woshinamoda/AD7768-/README.md

# AD7768
STM32H750采集ADI驱动数据
***

## 前言
有些朋友在github上看到了我AD7768的工程，从B站找到我咨询代码问题。由于确实有些学生毕设或者导师要求用到这个片子，我这边为了方便大家快速上手，重新整理更新一下内容。<br>

1. 我重新更新了代码，原先上传的原理图里直接用STM32主控读取有问题，需要修改飞线，在后面《程序说明文档注释》我有内部详细解释
2. 添加两个说明文档，方便大家快速上手这个片子电路设计思路和对应程序内寄存器配置思路

***
>* 更新2024-08-28 下
1. 添加程序说明文档注释
2. 添加serial plot上位机软件

***
>* 更新2024-08-28

1.添加原理图文档注释
*   1->详细解释了AD7768开发板设计原理图思路
*   2->讲述原理图电源和配置AD7768的方式
*   3->解释一些预留焊盘和设置阻容的功能

2.修改firmware<br>
修改内容：新增自己按照寄存器配置的函数和功能<br>
大体思路：通过STM32的spi1来配置AD7768的寄存器<br>
通过STM32的spi4从机模式，由AD7768的DCLK提供时钟，由AD7768的DRDY来模拟spi的cs引脚，读取AD7768的DOUT0输入<br>

>* 更新2023-08-10

1.更新AD7768新版程序
2.新增嘉立创原理图
3.更新picture设计图
