woshinamoda/AD7768-/picture/AD7768.png

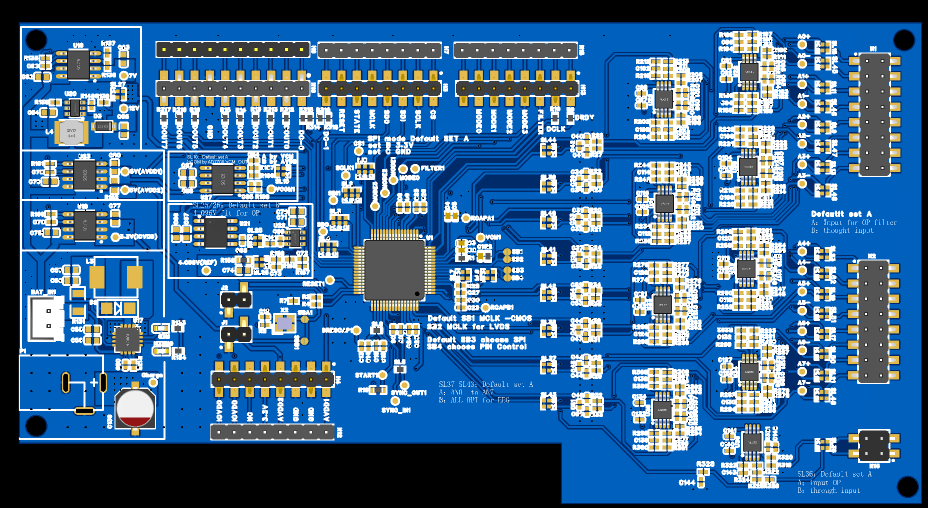
picture/AD7768.png
