woshinamoda/AD7768-/picture/STM32H750.png

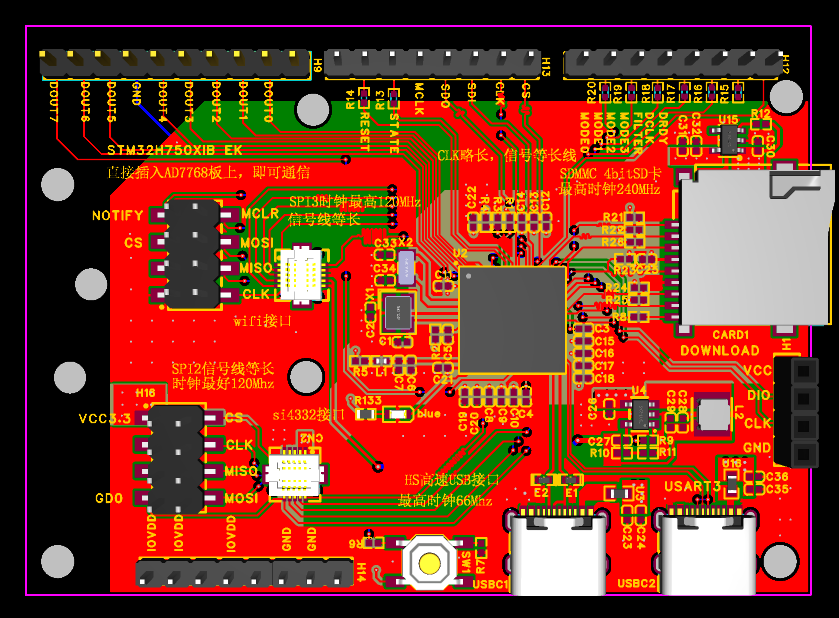
picture/STM32H750.png
