woshinamoda/AD7768-/(threads)

Thread 2 (2024-05-18):

mlck的分频系数是不是缺少16分频

yangkkokk, 2024-05-18:
typedef enum {
	AD7768_MCLK_DIV_32 = 0,
	AD7768_MCLK_DIV_8 = 2,
	AD7768_MCLK_DIV_4 = 3,
} ad7768_mclk_div;
这里是否缺少16分频，为何不用低功耗模式16分频，官方推荐的

woshinamoda, 2024-05-19:
这个只是我测试随便写的。因为我是用STM32的SPI从机读取数据，并不是并口的FPGA。采样率高对spi的时钟也就是DCLK有要求，DCLK是由MCLK分频的，我就默认都用最高速率
