woshinamoda/AD7768-/嘉立创原理图/STM32H750开发板.pdf

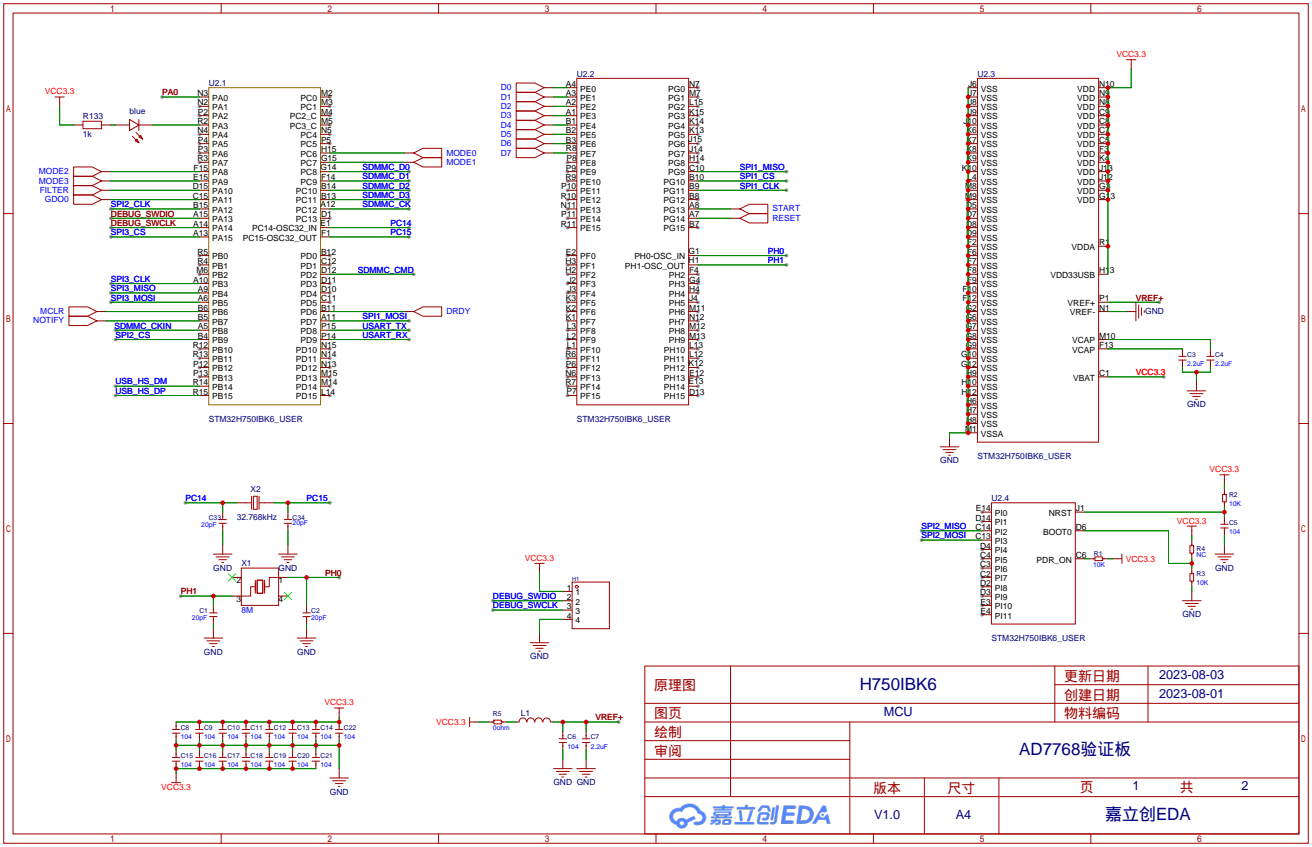
[picture p8: page 1]

VDD C5 VDD C7 VDD C8 VDD C9

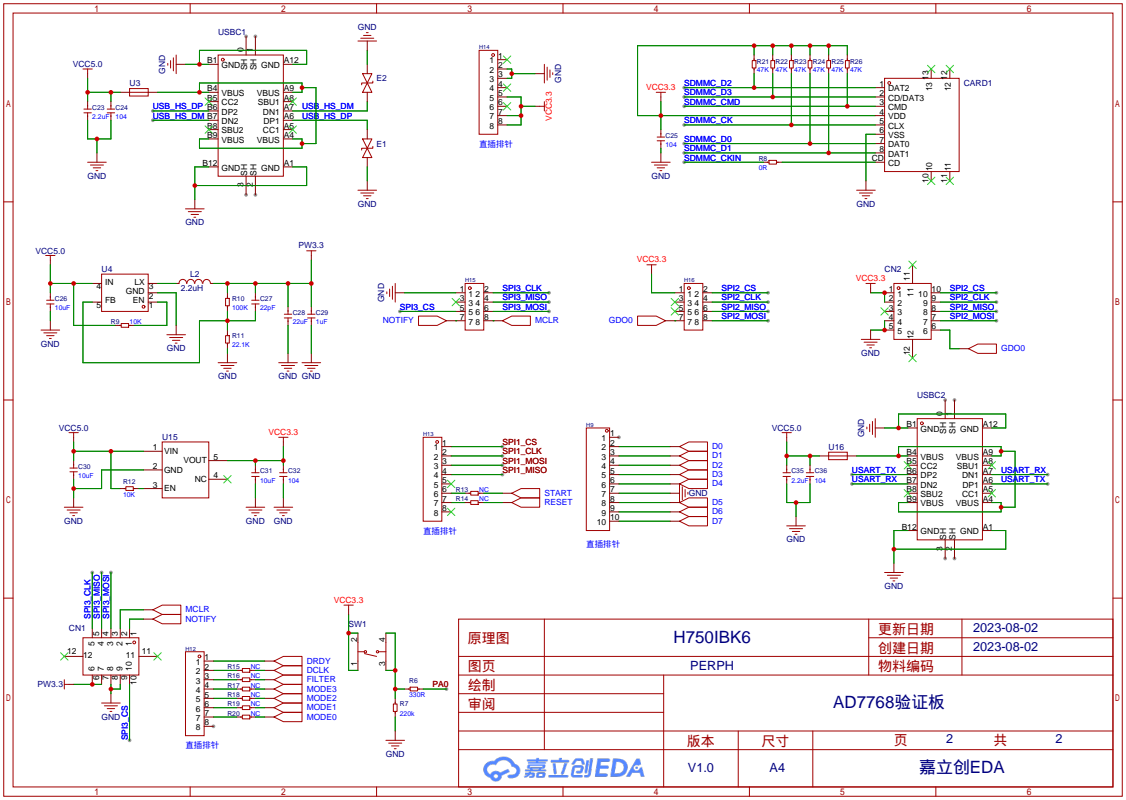
[picture p9: page 2]
