woshinamoda/AD7768-/firmware/Core/Src/main.c

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
/* Includes ------------------------------------------------------------------*/
#include "main.h"
#include "spi.h"
#include "tim.h"
#include "usart.h"
#include "usb_device.h"
#include "usb_otg_hs.h"
#include "gpio.h"

/* USER CODE BEGIN Includes */
#include "uApp_other.h"
#include "uApp_AD7768.h"
#include "uspi.h"
#include "ugpio.h"
/* USER CODE END Includes */


void SystemClock_Config(void);
void PeriphCommonClock_Config(void);
/**
  * @brief  The application entry point.
  * @retval int
  */
int main(void)
{
  /* MCU Configuration--------------------------------------------------------*/

  /* Reset of all peripherals, Initializes the Flash interface and the Systick. */
  HAL_Init();

  /* Configure the system clock */
  SystemClock_Config();

/* Configure the peripherals common clocks */
  PeriphCommonClock_Config();

  /* Initialize all configured peripherals */
  MX_GPIO_Init();
  MX_SPI1_Init();
  MX_USART3_UART_Init();
  MX_USB_DEVICE_Init();
  MX_TIM15_Init();
  MX_SPI4_Init();
  MX_USB_OTG_HS_PCD_Init();
  /* USER CODE BEGIN 2 */
	HAL_TIM_Base_Start_IT(&htim15);		//开启系统tick 

  /* USER CODE END 2 */

  /* Infinite loop */
  /* USER CODE BEGIN WHILE */
	my_ad7768_init();
  while (1)
  {

    /* USER CODE END WHILE */

    /* USER CODE BEGIN 3 */
  }
  /* USER CODE END 3 */
}

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
/* USER CODE BEGIN 4 */
void HAL_TIM_PeriodElapsedCallback(TIM_HandleTypeDef *htim)
{
  if (htim->Instance == TIM15) 
	{ //周期定时tick = 1ms
   	LED_Blinky();					//系统指示灯
  }

}
/* USER CODE END 4 */
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
