woshinamoda/AD7768-/firmware/Core/Inc/main.h

#define RESET_Pin GPIO_PIN_14
#define RESET_GPIO_Port GPIOG
#define START_Pin GPIO_PIN_13
#define START_GPIO_Port GPIOG
#define NOTIFY_Pin GPIO_PIN_7
#define NOTIFY_GPIO_Port GPIOB
#define MCLR_Pin GPIO_PIN_6
#define MCLR_GPIO_Port GPIOB
#define SPI1_CS_Pin GPIO_PIN_10
#define SPI1_CS_GPIO_Port GPIOG
#define DRDY_Pin GPIO_PIN_6
#define DRDY_GPIO_Port GPIOD
#define DRDY_EXTI_IRQn EXTI9_5_IRQn
#define FILTER_Pin GPIO_PIN_10
#define FILTER_GPIO_Port GPIOA
#define MODE3_Pin GPIO_PIN_9
#define MODE3_GPIO_Port GPIOA
#define MODE2_Pin GPIO_PIN_8
#define MODE2_GPIO_Port GPIOA
#define MODE1_Pin GPIO_PIN_7
#define MODE1_GPIO_Port GPIOC
#define MODE0_Pin GPIO_PIN_6
#define MODE0_GPIO_Port GPIOC
#define KEY_PA0_Pin GPIO_PIN_0
#define KEY_PA0_GPIO_Port GPIOA
#define LED_Pin GPIO_PIN_3
#define LED_GPIO_Port GPIOA
#define D7_Pin GPIO_PIN_7
#define D7_GPIO_Port GPIOE
#define CS_L 	HAL_GPIO_WritePin(GPIOG, GPIO_PIN_10, (GPIO_PinState)0)
#define CS_H	HAL_GPIO_WritePin(GPIOG, GPIO_PIN_10, (GPIO_PinState)1)
