woshinamoda/AD7768-/firmware/APPlication/uApp_AD7768.h

/***************************************************************************//**
 *   @file   ad7768.h
 *   @brief  Header file of AD7768 Driver.
 *   @author DBogdan (dragos.bogdan@analog.com)
********************************************************************************
 * Copyright 2016(c) Analog Devices, Inc.
 *
 * All rights reserved.
 *
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
 * THIS SOFTWARE IS PROVIDED BY ANALOG DEVICES "AS IS" AND ANY EXPRESS OR
 * IMPLIED WARRANTIES, INCLUDING, BUT NOT LIMITED TO, NON-INFRINGEMENT,
 * MERCHANTABILITY AND FITNESS FOR A PARTICULAR PURPOSE ARE DISCLAIMED.
 * IN NO EVENT SHALL ANALOG DEVICES BE LIABLE FOR ANY DIRECT, INDIRECT,
 * INCIDENTAL, SPECIAL, EXEMPLARY, OR CONSEQUENTIAL DAMAGES (INCLUDING, BUT NOT
 * LIMITED TO, INTELLECTUAL PROPERTY RIGHTS, PROCUREMENT OF SUBSTITUTE GOODS OR
 * SERVICES; LOSS OF USE, DATA, OR PROFITS; OR BUSINESS INTERRUPTION) HOWEVER
 * CAUSED AND ON ANY THEORY OF LIABILITY, WHETHER IN CONTRACT, STRICT LIABILITY,
 * OR TORT (INCLUDING NEGLIGENCE OR OTHERWISE) ARISING IN ANY WAY OUT OF THE USE
 * OF THIS SOFTWARE, EVEN IF ADVISED OF THE POSSIBILITY OF SUCH DAMAGE.
*******************************************************************************/
#ifndef UAPP_AD7768_H_
#define UAPP_AD7768_H_

/***********************SPI 4 interface **********************************
 SPI4 从机模式，请看手册P65详情描述
 硬件接口D2 接到 CLK		D2引脚为PE2，sck接到dclk上，用于接收数字时钟
 硬件接口D5 接到 D0			D5引脚为PE4，miso接到D0上，用于接收数据
 原先D0对应PA4引脚不要初始化，置为高阻态，否则影响输出
 
 = = = 接收包数据格式P62
 = = = SL6 SL7都接A，8个通道数据通过D0 1线传输，figure 99 // SPI速率60Mhz

SPI1 全双工主机模式
spi1数据格式，详细配置P50
= = = SB3接通，取消PIN Control

*************************************************************************/

#include "main.h"
#include "uspi.h"
#include "ugpio.h"
#include "sai.h"

/******************************************************************************/
/********************** Macros and Constants Definitions **********************/
/******************************************************************************/
#define AD7768_8_CH  											4
#define AD7768_REG_CH_STANDBY							0x00
#define AD7768_REG_CH_MODE_A							0x01
#define AD7768_REG_CH_MODE_B							0x02
#define AD7768_REG_CH_MODE_SEL						0x03
#define AD7768_REG_PWR_MODE								0x04
#define AD7768_REG_GENERAL_CFG						0x05
#define AD7768_REG_DATA_CTRL							0x06
#define AD7768_REG_INTERFACE_CFG					0x07
#define AD7768_REG_BIST_CTRL							0x08
#define AD7768_REG_DEV_STATUS							0x09
#define AD7768_REG_REV_ID									0x0A
#define AD7768_REG_DEV_ID_MSB							0x0B
#define AD7768_REG_DEV_ID_LSB							0x0C
#define AD7768_REG_SW_REV_ID							0x0D
#define AD7768_REG_GPIO_CTRL							0x0E
#define AD7768_REG_GPIO_WR_DATA						0x0F
#define AD7768_REG_GPIO_RD_DATA						0x10
#define AD7768_REG_PRECHARGE_BUF_1				0x11
#define AD7768_REG_PRECHARGE_BUF_2				0x12
#define AD7768_REG_POS_REF_BUF						0x13
#define AD7768_REG_NEG_REF_BUF						0x14
#define AD7768_REG_CH_OFFSET_1(ch)				(0x1E + (ch) * 3)
#define AD7768_REG_CH_OFFSET_2(ch)				(0x1F + (ch) * 3)
#define AD7768_REG_CH_OFFSET_3(ch)				(0x20 + (ch) * 3)
#define AD7768_REG_CH_GAIN_1(ch)					(0x36 + (ch) * 3)
#define AD7768_REG_CH_GAIN_2(ch)					(0x37 + (ch) * 3)
#define AD7768_REG_CH_GAIN_3(ch)					(0x38 + (ch) * 3)
#define AD7768_REG_CH_SYNC_OFFSET(ch)			(0x4E + (ch) * 3)
#define AD7768_REG_DIAG_METER_RX					0x56
#define AD7768_REG_DIAG_CTRL							0x57
#define AD7768_REG_DIAG_MOD_DELAY_CTRL		0x58
#define AD7768_REG_DIAG_CHOP_CTRL					0x59

/* AD7768_REG_CH_STANDBY */
#define AD7768_CH_STANDBY(x)							(1 << (x))

/* AD7768_REG_CH_MODE_x */
#define AD7768_CH_MODE_FILTER_TYPE				(1 << 3)
#define AD7768_CH_MODE_DEC_RATE(x)				(((x) & 0x7) << 0)

/* AD7768_REG_CH_MODE_SEL */
#define AD7768_CH_MODE(x)									(1 << (x))

/* AD7768_REG_PWR_MODE */
#define AD7768_PWR_MODE_SLEEP_MODE				(1 << 7)
#define AD7768_PWR_MODE_POWER_MODE(x)			(((x) & 0x3) << 4)
#define AD7768_PWR_MODE_LVDS_ENABLE				(1 << 3)
#define AD7768_PWR_MODE_MCLK_DIV(x)				(((x) & 0x3) << 0)

/* AD7768_REG_DATA_CTRL */
#define AD7768_DATA_CTRL_SPI_SYNC					(1 << 7)
#define AD7768_DATA_CTRL_SINGLE_SHOT_EN		(1 << 4)
#define AD7768_DATA_CTRL_SPI_RESET(x)			(((x) & 0x3) << 0)

/* AD7768_REG_INTERFACE_CFG */
#define AD7768_INTERFACE_CFG_CRC_SEL(x)		(((x) & 0x3) << 2)
#define AD7768_INTERFACE_CFG_DCLK_DIV(x)	(((x) & 0x3) << 0)

#define AD7768_RESOLUTION									24


//#define	CS_L		HAL_GPIO_WritePin(GPIOG, SPI1_CS_Pin, GPIO_PIN_RESET)
//#define	CS_H		HAL_GPIO_WritePin(GPIOG, SPI1_CS_Pin, GPIO_PIN_SET)


/******************************************************************************/
/*************************** Types Declarations *******************************/
/******************************************************************************/
typedef enum {
	AD7768_ACTIVE,
	AD7768_SLEEP,
} ad7768_sleep_mode;				//睡眠模式选择

typedef enum {
	AD7768_ECO = 0,
	AD7768_MEDIAN = 2,
	AD7768_FAST = 3,
} ad7768_power_mode;				//功率模式选择

typedef enum {
	AD7768_MCLK_DIV_32 = 0,
	AD7768_MCLK_DIV_8 = 2,
	AD7768_MCLK_DIV_4 = 3,
} ad7768_mclk_div;					//MCLK分频选择

typedef enum {
	AD7768_DCLK_DIV_8,
	AD7768_DCLK_DIV_4,
	AD7768_DCLK_DIV_2,
	AD7768_DCLK_DIV_1,
} ad7768_dclk_div;					//DCLK分频选择

typedef enum {
	AD7768_PIN_CTRL,
	AD7768_SPI_CTRL,
} ad7768_pin_spi_ctrl;			//spi设置还是gpio设置

typedef enum {
	AD7768_STANDARD_CONV,
	AD7768_ONE_SHOT_CONV,
} ad7768_conv_op;						//转换方式 连续转换or一次转换

typedef enum {
	AD7768_NO_CRC,
	AD7768_CRC_4,
	AD7768_CRC_16,
	AD7768_CRC_16_2ND,
} ad7768_crc_sel;						// CRC校验选择

typedef enum {
	AD7768_CH0,
	AD7768_CH1,
	AD7768_CH2,
	AD7768_CH3,
	AD7768_CH4,
	AD7768_CH5,
	AD7768_CH6,
	AD7768_CH7,
	AD7768_CH_NO
} ad7768_ch;								//通道选择

typedef enum {
	AD7768_ENABLED,
	AD7768_STANDBY,
} ad7768_ch_state;					//设置通道状态 

typedef enum {
	AD7768_MODE_A,
	AD7768_MODE_B,
} ad7768_ch_mode;						//通道模式

typedef enum {
	AD7768_FILTER_WIDEBAND,
	AD7768_FILTER_SINC,
} ad7768_filt_type;					// 滤波器类型，少了个Digital Filter engine ？？？

typedef enum {
	AD7768_DEC_X32,
	AD7768_DEC_X64,
	AD7768_DEC_X128,
	AD7768_DEC_X256,
	AD7768_DEC_X512,
	AD7768_DEC_X1024,
	AD7768_DEC_X1024_2ND,
	AD7768_DEC_X1024_3RD,
} ad7768_dec_rate;					// 设置抽样率


typedef enum {
	dc_mode = 0,
	ac_mode = 1
}ad7768_coupling_mode;			// 耦合模式

typedef struct {
	spi_desc								*spi_desc;	
	gpio_desc								*gpio_reset;
	uint8_t									gpio_reset_value;
	gpio_desc								*gpio_mode0;
	gpio_desc								*gpio_mode1;
	gpio_desc								*gpio_mode2;
	gpio_desc								*gpio_mode3;
	uint8_t									pin_spi_input_value;
	ad7768_pin_spi_ctrl			pin_spi_ctrl;
	ad7768_sleep_mode				sleep_mode;
	ad7768_power_mode				power_mode;
	ad7768_mclk_div					mclk_div;
	ad7768_dclk_div					dclk_div;
	ad7768_conv_op					conv_op;
	ad7768_crc_sel					crc_sel;
	ad7768_ch_state					ch_state[8];
	ad7768_ch_mode					ch_mode[8];
	ad7768_filt_type				filt_type[2];
	ad7768_dec_rate					dec_rate[2];
	
	ad7768_coupling_mode coupling_mode[4];
	uint8_t IEPE[4];
	uint8_t dev_type;
	uint16_t data_block_size;
	uint32_t gain[4];
	uint8_t trig;
	uint16_t rate;
	uint16_t tail;																			//结构体尾，复位后设为0x1234
} ad7768_dev;//初始化设置

typedef struct {
	/* SPI */
	spi_init_param					spi_init;
	/* GPIO */
	int8_t									gpio_reset;
	uint8_t									gpio_reset_value;
	int8_t									gpio_mode0;
	int8_t									gpio_mode1;
	int8_t									gpio_mode2;
	int8_t									gpio_mode3;
	/* Configuration */
	uint8_t									pin_spi_input_value;
	ad7768_sleep_mode				sleep_mode;
	ad7768_power_mode				power_mode;
	ad7768_mclk_div					mclk_div;
	ad7768_dclk_div					dclk_div;
	ad7768_conv_op					conv_op;
	ad7768_crc_sel					crc_sel;
} ad7768_init_param;		//初始化参数

/******************************************************************************/
/************************ Functions Declarations ******************************/
/******************************************************************************/
/* SPI read from device. */
int32_t ad7768_spi_read(ad7768_dev *dev,
			uint8_t reg_addr,
			uint8_t *reg_data);
/* SPI write to device. */
int32_t ad7768_spi_write(ad7768_dev *dev,
			 uint8_t reg_addr,
			 uint8_t reg_data);
/* SPI read from device using a mask. */
int32_t ad7768_spi_read_mask(ad7768_dev *dev,
			     uint8_t reg_addr,
			     uint8_t mask,
			     uint8_t *data);
/* SPI write to device using a mask. */
int32_t ad7768_spi_write_mask(ad7768_dev *dev,
			      uint8_t reg_addr,
			      uint8_t mask,
			      uint8_t data);
/* Set the device sleep mode. */
int32_t ad7768_set_sleep_mode(ad7768_dev *dev,
			      ad7768_sleep_mode mode);
/* Get the device sleep mode. */
int32_t ad7768_get_sleep_mode(ad7768_dev *dev,
			      ad7768_sleep_mode *mode);
/* Set the device power mode. */
int32_t ad7768_set_power_mode(ad7768_dev *dev,
			      ad7768_power_mode mode);
/* Get the device power mode. */
int32_t ad7768_get_power_mode(ad7768_dev *dev,
			      ad7768_power_mode *mode);
/* Set the MCLK divider. */
int32_t ad7768_set_mclk_div(ad7768_dev *dev,
			    ad7768_mclk_div clk_div);
/* Get the MCLK divider. */
int32_t ad7768_get_mclk_div(ad7768_dev *dev,
			    ad7768_mclk_div *clk_div);
/* Set the DCLK divider. */
int32_t ad7768_set_dclk_div(ad7768_dev *dev,
			    ad7768_dclk_div clk_div);
/* Get the DCLK divider. */
int32_t ad7768_get_dclk_div(ad7768_dev *dev,
			    ad7768_dclk_div *clk_div);
/* Set the conversion operation mode. */
int32_t ad7768_set_conv_op(ad7768_dev *dev,
			   ad7768_conv_op conv_op);
/* Get the conversion operation mode. */
int32_t ad7768_get_conv_op(ad7768_dev *dev,
			   ad7768_conv_op *conv_op);
/* Set the CRC selection. */
int32_t ad7768_set_crc_sel(ad7768_dev *dev,
			   ad7768_crc_sel crc_sel);
/* Get the CRC selection. */
int32_t ad7768_get_crc_sel(ad7768_dev *dev,
			   ad7768_crc_sel *crc_sel);
/* Set the channel state. */
int32_t ad7768_set_ch_state(ad7768_dev *dev,
			    ad7768_ch ch,
			    ad7768_ch_state state);
/* Get the channel state. */
int32_t ad7768_get_ch_state(ad7768_dev *dev,
			    ad7768_ch ch,
			    ad7768_ch_state *state);
/* Set the mode configuration. */
int32_t ad7768_set_mode_config(ad7768_dev *dev,
			       ad7768_ch_mode mode,
			       ad7768_filt_type filt_type,
			       ad7768_dec_rate dec_rate);
/* Get the mode configuration. */
int32_t ad7768_get_mode_config(ad7768_dev *dev,
			       ad7768_ch_mode mode,
			       ad7768_filt_type *filt_type,
			       ad7768_dec_rate *dec_rate);
/* Set the channel mode. */
int32_t ad7768_set_ch_mode(ad7768_dev *dev,
			   ad7768_ch ch,
			   ad7768_ch_mode mode);
/* Get the channel mode. */
int32_t ad7768_get_ch_mode(ad7768_dev *dev,
			   ad7768_ch ch,
			   ad7768_ch_mode *mode);
/* Initialize the device. */
int32_t ad7768_reset(void);


void ad7768_start(void);

void ad7768_stop(void);

void ad7768_coupling_set(uint8_t ch, uint8_t state);

void ad7768_IEPE_set(uint8_t ch, uint8_t state);

void ad7768_gain_set(uint8_t ch, uint32_t gain);

int32_t ad7768_reset(void);

void ad7768_setup(void);

void ad7768_ext_clk_set(void);

void ad7768_rate_set(uint16_t rate);

void digital_trig_set(void);

extern ad7768_dev ad7768_device;

#define MASTER 1
#define SLAVE  0


/* USER CODE BEGIN 0 */

void my_ad7768_init();
uint8_t ad7768_read_cmd(uint8_t reg_addr);
uint8_t add7768_write_cmd(uint8_t reg_addr, uint8_t data);
void ad7768_gain_set(uint8_t chn, uint32_t gain);
void ad7768_start(void);
void ad7768_stop(void);
void ad7768_gain_set(uint8_t ch, uint32_t gain);
void ad7768_rate_set(uint16_t rate);
void Fill_reg_List();


void ReadData_Handle();
uint8_t Data_CRC(uint8_t * code);
/* USER CODE END 0 */






#endif
