woshinamoda/AD7768-/(commit log)

2023-08-12 提交测试代码
2024-08-28 新修改固件测试8-28号
2024-08-28 添加串口示波器软件，更新软件和原理图文档
